MattKuebrich/flounder/images/flounder_v1.1_board.jpg

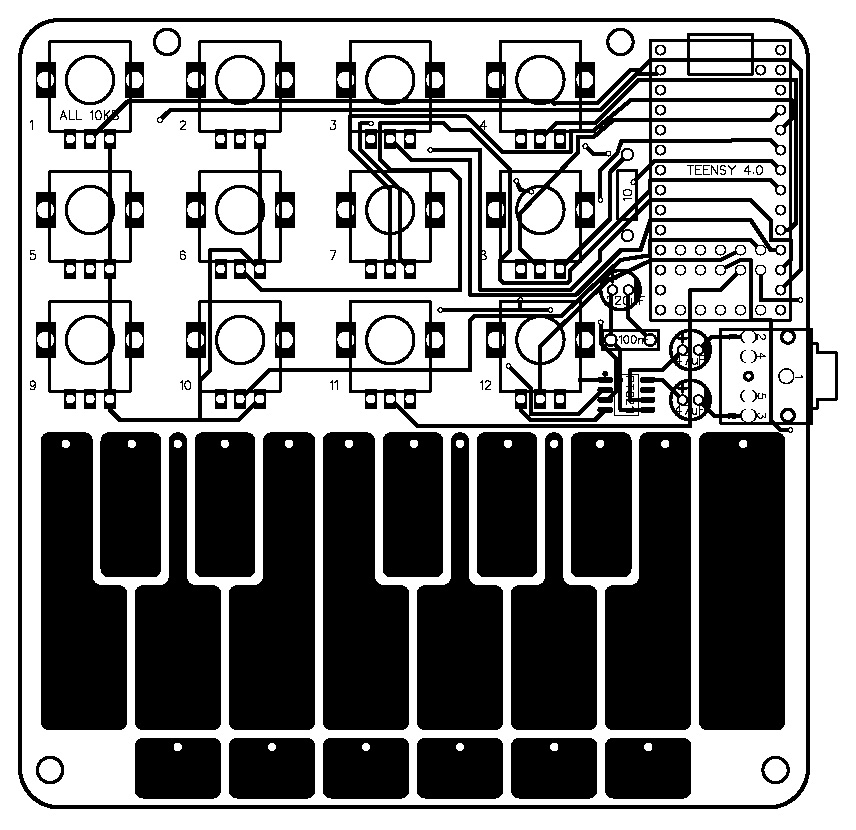
images/flounder_v1.1_board.jpg
