MattKuebrich/flounder/flounder_v1.1_schematic.pdf

## TEENSY 4.0

## all linear 10k pots

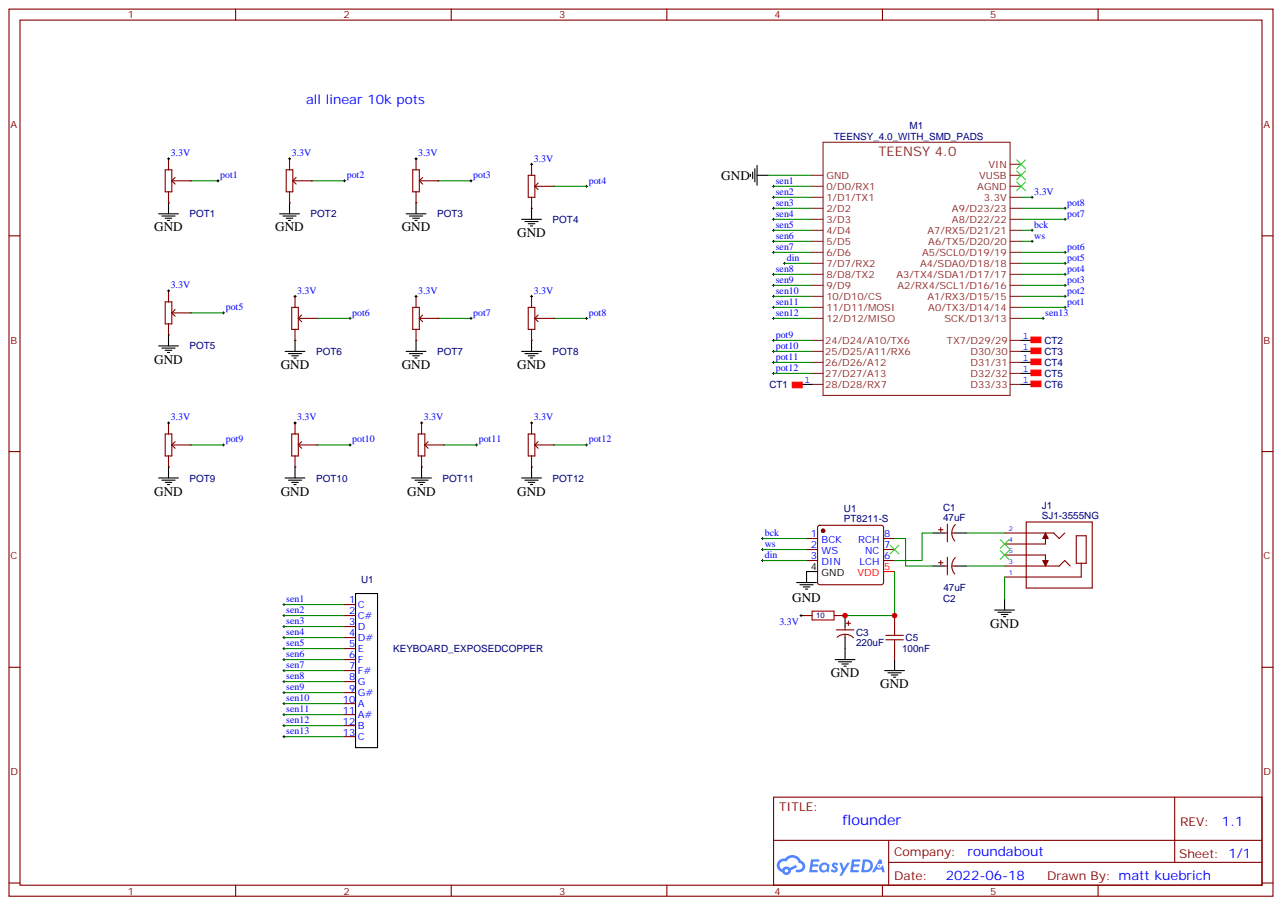
[picture p6: page 1]

Drawn By: matt kuebrich
