MattKuebrich/flounder/programs/flounder_relabi_sampledrum/AudioSample909clap.cpp

// Audio data converted from audio file by wav2sketch_js

#include "AudioSample909clap.h"

// Converted from 909clap.wav, using 44100 Hz, 16 bit u-law encoding
//PROGMEM
const unsigned int AudioSample909clap[4289] = {
0x01004300,0x82018000,0x87058402,0x94108e09,0x3533a118,0xffffffea,0xf6fdffff,0x7a6c66c9,
0x737f7f7f,0xe6e56e74,0x6c5be4f3,0x6a77736e,0x707b7c67,0xc86e7576,0xdae4eff0,0xba5a56c4,
0xf1f5eff1,0x646245dd,0xf3f0dfb5,0x03ddf1ec,0x686b6b53,0x5c5e6868,0xd9daa5ae,0x6b6f612b,
0xc0c25063,0xb431b435,0xdbe2e1d5,0x4ec4d3d4,0xeadeb24c,0xb8c5c8e4,0x42c4b1aa,0xd9bc4353,
0x515125d1,0x485b6562,0x163bccb5,0x56329db0,0xe1c65860,0xc2aed1e8,0x505f615b,0x2cd6cb23,
0x574e2ba0,0x31b59848,0x525a5553,0xd2d4c53c,0xd2c6c9c6,0xccd7cbc8,0xd5d31e34,0xd3d4d9d9,
0xccb1ced4,0x19b4cad2,0x4d544e42,0x430c3a4c,0x4d3f474b,0x5d5b5951,0x404f575d,0xc6d0b832,
0xd5d9d0b7,0xd1c0c7d3,0xa5adc9ce,0x4e5343a9,0x321e1232,0x44453339,0xbfab3035,0xafc6a3aa,
0x42443f09,0x4137393a,0xa8992f3d,0xc0c1b508,0xc2ccceca,0xc6c8c9c0,0x18a6a2a5,0x3d433ca0,
0x37434b4a,0x242c3703,0x13333635,0x1e00b5b3,0x22949615,0xc1b7b395,0x223028b3,0xaca59d96,
0xb1001392,0x02179fba,0x3b3d3100,0x33383936,0xc7b9a519,0xcccac5ca,0xa5b7c5c7,0x11a6abae,
0x43464031,0x38333639,0x3723273b,0x40403d3c,0x1d2b343b,0xb3adb0af,0xbcbfb4b1,0xb3b3b7c0,
0x989da8a5,0x9aa89a95,0x32271890,0x22132329,0x0a0d1f2c,0xb5b5ab96,0xb9bbbdb8,0xc0c0c0bd,
0xb4b3b5be,0x2b149baf,0x33373937,0x3c393733,0x42413c40,0x373a3e41,0x0a252a30,0xb8b5aaa1,
0xbfc1c1be,0xaeb6bdbd,0xb1aeaea9,0xb8b6b7b4,0xacaaadb2,0x2c2194a0,0x303d3336,0x6ff3e247,
0xe264707f,0x7f7f77e2,0x27677b7d,0xa6d6d7aa,0xfffffce1,0xebeefaff,0x6f91e3ed,0xde3f6472,
0xd3f3f4e8,0x716a726f,0x77797f7e,0xd622717a,0xf0f2f7e4,0x37e1e3f3,0x59dce0df,0xbf3e241f,
0xc5dadb48,0x695c34d8,0xe4e1d549,0xc5d6dce7,0x0fdcc7c9,0x6a59b259,0x68625d71,0xb5606460,
0xdae9ece7,0xe4e1d6a2,0xa9c4c9e4,0x48413823,0x33565b5a,0x5e6b5826,0x7069605a,0x5b616469,
0x48464b55,0xeee1c039,0xf7f3f6f6,0xf0e4e2ef,0xd8e9eff0,0x4fa9bac5,0x6f6c665e,0x48585d63,
0x60606162,0x59625c59,0x9ca64649,0x832bd1c9,0x95464536,0xc3c9cdc9,0xe0d1cdc5,0xb7c2b2ce,
0xbbd12c30,0x494ba2b5,0x42271f4e,0xbbb1b12a,0xd1ad1b24,0xd4d8d5d7,0x8fccd4d7,0x40404a32,
0x51524b4c,0x31323e41,0xaf395049,0x573cc3bc,0x88344852,0xb2c6b411,0x3d374544,0x27343a3d,
0xddd6ccb0,0xdbe0dfd9,0x84bbc8d4,0x453e321b,0x90beb42d,0x5046303b,0x424e504d,0x43343c39,
0x2f444844,0xb03e493b,0x11b8c7c1,0xa69a1304,0x18afb186,0xb2b3ad20,0xab1515b3,0xb1b4bebc,
0x8f9017a3,0xc3c4bcb2,0xb7bbb7b3,0xa6b7b8af,0xb0b4bcb6,0x94a6a0ac,0x47434138,0x464c4a48,
0x4846464a,0xa0223b42,0xadb9baaf,0xc9c7c1b4,0xc4c3c9cd,0xaca7bbc3,0x98b0b0b2,0x44383026,
0x34394145,0x373f3c2c,0x2d313538,0x89a09025,0x0993959a,0xb1a9980f,0xc2c0c0b9,0xbdc3c2c5,
0x80a9b6bb,0x13222528,0xa194030d,0xb1a9a7a2,0x210993a3,0x36363031,0x22283235,0x272b2b20,
0x2122302d,0x81958511,0x9ea3a897,0x9da9a79c,0x2b272513,0x21201b24,0x071c1f1b,0xb9afa998,
0xc1b4b5b3,0xc2adc2bb,0xff34c39e,0xeeffffff,0x646a63d4,0x76776771,0x7f7f7f77,0x4765787f,
0xd8bff0e2,0xf7fffae8,0xe0db6569,0x546366df,0xda4b6d6c,0x30cdd1e6,0x74645195,0xecdb5071,
0xf1f5f5eb,0x6b4bd4ee,0x7069545e,0x6a736b64,0xe3ead949,0xdbefe3e8,0x6163521b,0x7173716e,
0xd4596870,0xfaf3e5e7,0xe4eaf7fb,0xf1f3ede4,0x47dae3dd,0x392a5448,0x58686a50,0x57625e50,
0x71717066,0x6d71706c,0xe8e0a15f,0xebe7e4e3,0x4d50b1e5,0xc2495151,0xc5dfe3de,0xcdc9c7c4,
0xd7cbbbd9,0xdec7a4c3,0xd3dbe6e3,0xc0d4e0e1,0x58645e45,0x63411c44,0x66626163,0x5d657070,
0x15524f3d,0xad3d464a,0xc0cfb4ca,0xe7d7b724,0xe6e3e4ec,0x97c5cce2,0xb0304b41,0xc5b82d0c,
0x47b0ccc5,0xc2b41440,0x54585329,0x53514b52,0x92314548,0x942b29a3,0x80c0ab29,0x84b0243a,
0x14a33743,0xd2c3c1a0,0xced1d6d6,0xc4bfcdd3,0xc4c5d0c9,0x46432cb5,0x4a464b48,0x48444b51,
0xaca72b43,0xc7c2b4b6,0xb8a8c7cc,0xc7c2c0be,0xbabdc6cc,0x2d30a4ba,0x3b3c3722,0x303f433d,
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
};
