MattKuebrich/flounder/programs/flounder_relabi_sampledrum/AudioSample909kick.cpp

// Audio data converted from audio file by wav2sketch_js

#include "AudioSample909kick.h"

// Converted from 909kick.wav, using 22050 Hz, 16 bit u-law encoding
//PROGMEM
const unsigned int AudioSample909kick[2321] = {
0x02002420,0x32218087,0x4e4a453e,0x5150504f,0x494d5051,0x3f424649,0x36353438,0x9c292c32,
0xbebbb7b0,0xd1cec9c4,0xcecdd0d1,0xdad2cfd0,0xf3eee8e2,0xfffffbf7,0xffffffff,0xffffffff,
0xffffffff,0xffffffff,0xffffffff,0xffffffff,0xf6f9fcff,0xe4ebf0f3,0x34b8d0dc,0x6762594e,
0x73716f6b,0x78777574,0x7a7a7a79,0x7c7b7b7a,0x7b7c7c7c,0x797a7b7b,0x76777879,0x71737475,
0x65696d70,0x46545d62,0xd5ccba25,0xebe7e2dd,0xf6f4f2f0,0xfcfbf9f8,0xfefdfdfc,0xfffffffe,
0xffffffff,0xfefeffff,0xfafbfcfd,0xf4f6f8f9,0xe8ecf0f2,0xd1d9e0e5,0x4d3f10c0,0x64615b55,
0x706e6a67,0x75747371,0x78787776,0x79797979,0x7a7a7979,0x7a7a7a7a,0x79797a7a,0x77787878,
0x74757676,0x70717273,0x65686a6d,0x51575e62,0xb8073847,0xe1dad3c8,0xefebe8e4,0xf6f5f3f1,
0xfafaf9f7,0xfdfcfcfb,0xfefefdfd,0xfefffefe,0xfdfefefe,0xfbfcfcfd,0xf8f9fafb,0xf4f5f7f8,
0xedf0f1f3,0xdfe3e6e9,0xb2c5d1d8,0x534b4024,0x64615d58,0x6d6b6966,0x73727170,0x76757574,
0x78777777,0x79797878,0x79797979,0x7a7a7a7a,0x79797979,0x78787878,0x76777777,0x74757576,
0x71727273,0x696b6d70,0x60636567,0x4c53575c,0xbc9f3042,0xdcd7d1c8,0xe9e6e3e1,0xf2f0eeec,
0xf6f5f4f3,0xf9f8f8f7,0xfbfafafa,0xfcfcfbfb,0xfdfcfcfc,0xfcfdfdfd,0xfbfcfcfc,0xfafafafb,
0xf8f8f9f9,0xf5f6f6f7,0xf1f2f3f4,0xe8eaedf0,0xdbe0e2e5,0xbec8d1d6,0x483e27a5,0x5d595450,
0x66656260,0x6e6c6a68,0x72717070,0x75747473,0x77767676,0x78787777,0x78787878,0x79797979,
0x79797979,0x79797979,0x78787878,0x77777878,0x76767777,0x74757576,0x72737374,0x6f707171,
0x686a6b6d,0x61636566,0x53575b5f,0x32414850,0xc8c0b007,0xdcd8d4d0,0xe6e4e2e0,0xefedebe9,
0xf3f2f1f0,0xf6f6f5f4,0xf8f8f7f7,0xfaf9f9f9,0xfbfafafa,0xfbfbfbfb,0xfcfcfbfb,0xfbfcfcfc,
0xfafbfbfb,0xf9f9fafa,0xf8f8f8f9,0xf6f6f7f7,0xf4f4f5f5,0xf1f1f2f3,0xeaeceef0,0xe2e4e6e8,
0xd4d8dce0,0xb2c0c8d0,0x453d2d8f,0x5855514c,0x62615f5b,0x68676564,0x6e6d6b6a,0x7171706f,
0x74737372,0x76757574,0x77777676,0x78787777,0x78787878,0x78787878,0x79797979,0x79797979,
0x78797979,0x78787878,0x77777778,0x76767777,0x75767676,0x74747575,0x73737374,0x70717272,
0x6c6e6f70,0x67696a6b,0x62636466,0x595b5e60,0x4a505356,0x16313d44,0xc7c1b6a4,0xd8d5d2cd,
0xe2e0dedb,0xe9e7e5e4,0xefedecea,0xf2f2f1f0,0xf5f4f4f3,0xf7f6f6f5,0xf8f8f8f7,0xf9f9f9f8,
0xfafaf9f9,0xfafafafa,0xfbfbfafa,0xfbfbfbfb,0xfafbfbfb,0xfafafafa,0xf9f9f9f9,0xf8f8f8f8,
0xf6f7f7f7,0xf5f5f6f6,0xf3f4f4f5,0xf1f2f2f3,0xedeff0f0,0xe7e9eaec,0xe0e2e4e5,0xd5d8dbde,
0xc2c8ced2,0x2d0aa8b8,0x4d48423a,0x59565451,0x61605e5c,0x66656462,0x6b6a6867,0x6f6e6d6c,
0x71717070,0x73737272,0x75747474,0x76767575,0x77777776,0x78777777,0x78787878,0x78787878,
0x78787878,0x78787878,0x78787878,0x78787878,0x78787878,0x77777778,0x77777777,0x76767676,
0x75757676,0x74757575,0x73747474,0x72727373,0x70717172,0x6e6f7070,0x6a6b6c6d,0x65666769,
0x61626364,0x5a5c5e60,0x50535557,0x3e44484d,0xa5042735,0xc9c4beb4,0xd6d3d1ce,0xe0dddbd8,
0xe5e3e2e1,0xeae8e7e6,0xefedeceb,0xf1f1f0f0,0xf4f3f3f2,0xf5f5f5f4,0xf7f6f6f6,0xf8f8f7f7,
0xf8f8f8f8,0xf9f9f9f9,0xf9f9f9f9,0xfafaf9f9,0xfafafafa,0xfafafafa,0xfafafafa,0xf9f9fafa,
0xf8f9f9f9,0xf8f8f8f8,0xf7f7f7f7,0xf6f6f6f7,0xf5f5f5f6,0xf4f4f4f5,0xf2f3f3f3,0xf0f1f1f2,
0xedeeeff0,0xe9eaebec,0xe3e5e6e7,0xdde0e1e2,0xd3d5d8da,0xc2c7ccd0,0x12a1b2bc,0x443f362b,
0x53504d48,0x5b595755,0x61605f5d,0x65646362,0x69686766,0x6c6c6b6a,0x706f6e6d,0x71717070,
0x73727272,0x74747373,0x75757574,0x76767675,0x77777776,0x77777777,0x78777777,0x78787878,
0x78787878,0x78787878,0x78787878,0x78787878,0x78787878,0x77777878,0x77777777,0x76767777,
0x76767676,0x75757676,0x75757575,0x74747474,0x73737474,0x72737373,0x71717272,0x70707171,
0x6d6e6f70,0x6a6b6c6d,0x67686969,0x63646566,0x60616262,0x595b5c5e,0x51535557,0x44484c50,
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
};
