MattKuebrich/flounder/programs/flounder_relabi_sampledrum/AudioSample909snare.cpp

// Audio data converted from audio file by wav2sketch_js

#include "AudioSample909snare.h"

// Converted from 909snare.wav, using 44100 Hz, 16 bit u-law encoding
//PROGMEM
const unsigned int AudioSample909snare[9089] = {
0x01008d87,0x80800080,0x80808080,0x00008080,0x02008000,0x14120c05,0x11010712,0x3630271e,
0x332f3338,0x5350463c,0x53525253,0x5a555151,0x706f6760,0xde99626c,0x5134d3e1,0xd5dace3c,
0xe7e3d7cf,0xd4d7e5ea,0xe8e0dedd,0xcadce9ee,0xd6ddd1ba,0xc8d4c7c3,0x52555944,0x706d6862,
0x6b554b63,0xe2e9356d,0x72767764,0xc8db3c69,0x515f655b,0xe8e0ccc2,0xf2f0ede7,0xf5f3f1f2,
0xf5f9fbf6,0xfcf1dfef,0xfffcf4f6,0xdcf2feff,0xfafefdf0,0xfffaf8fb,0xfff9f6fe,0xfffffeff,
0x6f49c6f2,0x5add8973,0x58424969,0x74c3e024,0x446d7d7f,0x7f7b7361,0x6a50707f,0x7f7d7b78,
0xe9d05777,0xb8d5e3f0,0xe6fef8dc,0xdcf0ea3a,0xe2f8f9e5,0xf5f3e5d5,0xf4f8e7ec,0xeb966f58,
0x5343d5ef,0x743d2964,0x7260687b,0x46dadd65,0x71757565,0x79717474,0x707b7f7f,0x73e3f239,
0x7b777c7f,0x6e777a7f,0x7f74b0d0,0x7f7f7e7e,0x7f7d787c,0x7f7f7e7f,0x7f7b777c,0x7f7f7f7f,
0x7f7e7777,0x7f79747a,0x736c6a7a,0x6d687778,0x70706c70,0xebf25b72,0x58706d5a,0x5442685a,
0xd04e7578,0xc32261a4,0x7435e0c2,0x5d55717c,0xf2e5db46,0xe2eae8eb,0x6854d1e2,0xe1e50663,
0xa4e6f0e5,0xd51d5e58,0xfffad054,0xf1f0e3f2,0xd2e4f8f9,0xe7f4f9ed,0xf6f8f4ec,0xf9ecd5e2,
0xbe3ee2f6,0xf6f8f6f1,0xf0f3f0ec,0xeaac0be3,0xe5e0e6f0,0xe7dfeceb,0xf5f9fffb,0xecf8fffc,
0xf5f3f3ed,0xf4fdfffc,0xfffffff7,0xfaffffff,0xf8fbfef9,0xe6f5fffc,0xf0eaf3f0,0xe4f8fffa,
0xc5f6fef0,0xf5f2e598,0xc5d5e9f3,0xf4f6e9cd,0xdce7e0e4,0xf0e3a64b,0xd5b447e2,0x5e6b6ab1,
0xe7cc525e,0x7b7c68df,0x73767272,0x74767772,0x7f7f7f79,0x7b7f7f7f,0x7f7f7f7b,0x797a7c7e,
0x7f7d7c7b,0x7c7a7e7f,0x76767f7f,0x7a75797e,0x7f7f7f7f,0x64757f7e,0x7575756f,0x727b7f7b,
0x76777873,0x777c7877,0x6c625f68,0x67767e78,0x575f6562,0xd23f6c6d,0x5b716e41,0x52513ccb,
0x4c6f6864,0x5b57d2e8,0x3bc6cc49,0xe7f0f1d8,0xb0e5eceb,0xe4f7f1c3,0xeee7d53b,0x38d5f5f8,
0xf5f1e3c4,0xf4f1f3f5,0xece9e7f1,0xf9ebe9ec,0xf8f3faff,0xd6d1f2fa,0xfffffef6,0xf4f8ffff,
0xe4e0ebf7,0xfafff9ed,0xf4fbfefa,0xeef0e7ee,0xf8f4e3e1,0xe9f1efef,0xeef7f2e7,0xf1fbfae9,
0xedf8efe2,0x26d0dad7,0xeae9e9ca,0x4be4f7f8,0xd8e2a05a,0xdff3eccc,0xd25b7267,0xd9e8e4d5,
0x5832ded9,0x92e3c943,0x58865062,0xebe0626c,0xcf436038,0x5c6b7155,0xcce3de35,0x59c38526,
0x54597173,0xe1de5265,0xca5055c2,0x3e495d21,0xdf4f6458,0x6b6f4fdc,0xc1c7d73c,0x5337c3cd,
0x49afa450,0x4f30b504,0x4b90515f,0x383d5f65,0x6aa2b44d,0x43d2c364,0x3f9a4e62,0xe3d6aea6,
0x676d66b2,0x4955475e,0x58c5b899,0x60424a62,0x5a716e62,0x44543b87,0x564a44a8,0x4d2c3555,
0x08df9f58,0x45596567,0x665a442c,0x4dcec261,0x6f62545a,0x594c5363,0x546b6b6c,0x625a6151,
0x69bf345c,0x484e6e78,0xb7335d5a,0x39626960,0x63685c13,0x4362615a,0x7061d3d8,0x58616669,
0x50635a54,0x646b58b9,0x6e694226,0xb2424b58,0x6957332c,0xe0b2656e,0x5f5843c0,0x61bfe1ba,
0xd6e0dd48,0xc0a8a1d2,0xf0e9c92d,0xc4dae7ec,0xe0b2b6c8,0xeae9dbdd,0xe4e6efec,0xdfe1e8eb,
0xf3f0e5e0,0xe2dfe8f2,0xd1d4e3e8,0xe7dee3de,0xede0e1ec,0xe8e6e3e9,0xe4e4e6eb,0xf0d7b3d9,
0xebebe6ee,0xd534cce8,0xe5e1d1dc,0xd7e3e5e2,0xe8e3a581,0xcbd7e4e1,0xecdac5d9,0x5b3adbea,
0xeabc6463,0xd698ceec,0xc7c424c5,0xd5596e60,0x3e5847d4,0x56515123,0x5d514d58,0x41462c51,
0xbe2a5653,0x40635aba,0x6854d3d5,0x60626469,0x63645b54,0xca466265,0x616c7156,0x4a5a6162,
0x5b5915c9,0x215c6b66,0x616b6d59,0x584b1947,0x726c625f,0x1e9fc061,0x5b64644e,0x72675251,
0x59464666,0x64664a46,0x26824d59,0x32345d5c,0x32606960,0x5342aebc,0xd4d3a84d,0xb8c134a9,
0x51524635,0xd7dab54b,0xd1d0b8ba,0xd1c9a4bb,0x3cd6d7d1,0xe1ce555e,0xc6dee4e3,0xa8dcb427,
0xd9cf5362,0xd4cedbe0,0xddd5d1d0,0xd39b1fd8,0xceafb3d4,0xe3315041,0x5528d6eb,0xc4afc044,
0x44d3c6c4,0xc3224959,0xd8e2e5d6,0x4cbadbdd,0x44b1a44b,0xd4dcc63e,0x54b3b925,0xd4d2bd46,
0xd0c4c2c3,0x4e6058a8,0xd8d99434,0xbc9827ae,0x20d3d0b1,0x305d685e,0x34d8e6dc,0x4f9cc625,
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
};
