MattKuebrich/flounder/programs/flounder_relabi_sampledrum/AudioSample909rimsh.cpp

// Audio data converted from audio file by wav2sketch_js

#include "AudioSample909rimsh.h"

// Converted from 909rimSh.wav, using 44100 Hz, 16 bit u-law encoding
//PROGMEM
const unsigned int AudioSample909rimsh[577] = {
0x010008a0,0xc3058604,0xf6f2ece0,0xfdfcfbf9,0xfffffffe,0xfeffffff,0x5be0f9fd,0x71716f69,
0x71717171,0x71717171,0x71717171,0x6e707070,0xf6efc766,0xfdfcfbfa,0xfdfdfdfd,0xfbfcfcfd,
0x629feff9,0x70706e6a,0x71717171,0x71717171,0x70717171,0x70707070,0xde5b6c6e,0xfbf9f7f1,
0xfdfdfcfc,0xfcfdfdfd,0xfbfbfcfc,0xf1f7f9fa,0x6b6655d6,0x706f6f6e,0x70707070,0x6f707070,
0x6d6e6f6f,0x60686b6d,0xeee5d144,0xf3f3f3f1,0xb4dfebf1,0x6b686355,0x6e6e6d6c,0x6f6f6f6f,
0x6f6f6f6f,0x6e6e6f6f,0x6c6d6d6e,0xd057676b,0xf8f6f3ea,0xfafaf9f9,0xfafafafa,0xfafafafa,
0xf9f9f9fa,0xf7f8f8f9,0xf6f6f7f7,0xf4f4f5f5,0xf4f4f4f4,0xf6f5f5f5,0xf6f6f6f6,0xf7f7f7f7,
0xf6f6f7f7,0xf5f5f6f6,0xebf1f3f4,0x5e48c5e0,0x6c6b6965,0x6e6d6d6d,0x6d6e6e6e,0x6c6d6d6d,
0x696b6b6c,0x535e6367,0xdbd1b73c,0xeae9e6e2,0xe9ebebeb,0xdae1e4e7,0x38a3c5d2,0x5d59534a,
0x64636260,0x64646464,0x60616263,0x57595c5e,0x52525355,0x58565352,0x6462605c,0x69696766,
0x6b6b6b6a,0x6c6c6c6c,0x6c6c6c6c,0x6c6c6c6c,0x6c6c6c6c,0x6b6b6b6c,0x696a6a6a,0x64666768,
0x53595f62,0xa42b414c,0xd3cfc7bc,0xe0dddad6,0xe6e4e3e1,0xedebe9e8,0xf0f0efee,0xf2f2f1f1,
0xf3f3f2f2,0xf3f3f3f3,0xf3f3f3f3,0xf3f3f3f3,0xf2f2f2f2,0xf0f0f1f1,0xe8eaedee,0xdadfe2e5,
0xc4cad1d5,0x9da9b4bd,0x1110088b,0x9d92820b,0xb4b1aca5,0xbfbdbab7,0xc0c0c0c0,0xbcbdbfc0,
0xb2b5b7b9,0xa6a9adb0,0xa2a1a2a4,0xaaa7a5a3,0xb5b3b1ae,0xbbbab8b7,0xb8babbbb,0x9ca9b1b5,
0x3d33260c,0x524e4943,0x5e5b5855,0x64636160,0x67666565,0x68686867,0x69696868,0x69696969,
0x69696969,0x68686969,0x68686868,0x67676868,0x66676767,0x65656666,0x63636464,0x5f606162,
0x55585a5c,0x444a5052,0xa516313d,0xccc7c1b6,0xd8d6d3d1,0xe0dedcda,0xe2e1e1e0,0xe2e2e2e2,
0xe2e2e2e2,0xe0e1e1e1,0xdedfe0e0,0xdbdbdcdd,0xd8d8d9da,0xd5d6d6d7,0xd3d3d4d4,0xd1d1d2d2,
0xcfcfd0d0,0xcbcccdce,0xc9c9cacb,0xc8c8c8c8,0xc8c8c8c8,0xc9c9c8c8,0xcbcbcaca,0xcecdcdcc,
0xcfcfcece,0xcececfcf,0xcacbcccd,0xc4c6c7c9,0xb6bbc0c2,0x0999a8b1,0x3a342d21,0x49464340,
0x52504e4c,0x57565453,0x5b5a5958,0x5f5e5d5c,0x61606060,0x62616161,0x62626262,0x63636362,
0x63636363,0x62626262,0x61626262,0x60616161,0x5e5f5f60,0x5a5b5c5d,0x56575859,0x52535455,
0x4b4d4f51,0x43454749,0x3a3d4042,0x2b303336,0x0f192126,0xa0989081,0xaca9a6a3,0xb2b1b0af,
0xb6b5b4b3,0xb7b7b7b6,0xb8b8b8b8,0xb9b9b9b9,0xbab9b9b9,0xbabababa,0xbcbcbbbb,0xbfbebdbd,
0xc1c0c0bf,0xc3c2c2c1,0xc5c4c4c3,0xc6c6c6c5,0xc8c7c7c7,0xc8c8c8c8,0xc8c8c8c8,0xc6c7c7c7,
0xc3c4c5c6,0xc0c1c2c3,0xb6b9bbbe,0xa8adb1b4,0x0e8998a2,0x302a241b,0x3d3a3633,0x44434140,
0x4a494846,0x504f4d4c,0x52515150,0x54545353,0x55555554,0x56565656,0x57575756,0x57575757,
0x56575757,0x56565656,0x55555556,0x54545454,0x52535353,0x51515152,0x4f505050,0x4c4d4d4e,
0x494a4a4b,0x46474748,0x43444545,0x41424243,0x3e3f4040,0x3a3b3c3d,0x37383939,0x33343536,
0x30313233,0x2a2c2e2f,0x23252729,0x181b1f21,0x00081014,0x98938f87,0xa4a2a09c,0xacaaa8a6,
0xb1b0afae,0xb5b4b3b2,0xb7b6b6b5,0xb9b8b8b8,0xb9b9b9b9,0xb9b9b9b9,0xb7b8b8b8,0xb4b5b6b7,
0xb0b2b3b3,0xa8aaadaf,0x999fa2a5,0x0f028a93,0x25211d16,0x312f2c28,0x38363433,0x3e3c3b39,
0x4241403f,0x44444342,0x46464545,0x48484747,0x49494948,0x4a4a4a4a,0x4b4b4b4b,0x4b4b4b4b,
0x4b4b4b4b,0x4b4b4b4b,0x4a4a4b4b,0x4a4a4a4a,0x49494949,0x48484848,0x47474748,0x46464647,
0x45454545,0x44444444,0x43434343,0x42424242,0x40414141,0x3f404040,0x3c3d3e3e,0x3a3a3b3c,
0x37373839,0x34343536,0x31313233,0x2b2d2e30,0x25262829,0x1e202223,0x1214171a,0x8103090e,
0x928f8a86,0x99989694,0x9f9e9c9b,0xa1a1a0a0,0xa1a1a1a1,0xa0a1a1a1,0x9d9e9fa0,0x97989a9c,
0x8d919395,0x06018388,0x1613100b,0x211f1c19,0x27262422,0x2e2c2a29,0x3231302f,0x35343332,
0x37373635,0x3a393938,0x3c3b3b3a,0x3e3d3d3c,0x3f3f3f3e,0x40404040,0x41404040,0x41414141,
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
};
