MattKuebrich/flounder/(commit log)

2022-06-18 adding schematic
2022-07-06 adding power info
2022-07-13 added gerber
2022-07-14 adding info about smd pin header
2022-09-01 added TeensyDuino info
